johnmarkobura/analog-temperature-controller/ltspice/hysteresis_temperature_controller.asc

Heater: res; 44
LED: LED; LEDMODEL
R1: res; 481
R2_a: res; 5.1k
R2_b: res; 5.1k
Ra: res; 100
Rb: res; 1082
Rbottom: res; {1000*(1-a)}
Rc: res; 100
Rd: res; 1082
Re: res; 300
Rf: res; 39k
Rg: res; 1.2k
Rs: res; 5.6k
RT: res; R={-8.53503*TEMP(time)+1206.56688}
Rtop: res; {1000*a}
Schmitt: UniversalOpAmp2
SUB: UniversalOpAmp2
Temperature: bv; V=TEMP(time)
Transistor: npn3
V20: voltage; 20
V_ref: voltage; 5
VCC: voltage; 5
VEE: voltage; 5
VF1: UniversalOpAmp2
VF2: UniversalOpAmp2
Named nets: V2, 0, VCC, VEE, Vref, Vin, Vip, V1, V_sub, +20V, v_schmitt, Temperature
.param a=0.5
.model LEDMODEL D(Is=1e-20 N=2 Rs=10)
.func TEMP(t) table(t, 0,80, 50,90, 100,80)
.tran 0 100
