johnmarkobura/analog-temperature-controller/(commit log)

2026-09-05 Enhance README with project overview and details
    Expanded project details, including key features, thermistor characterization, signal conditioning, Schmitt trigger behavior, LTspice simulation results, hardware results, and tools used.
2026-09-05 Enhance README with project details and results
    Updated project description and added details about hysteresis, physical prototype results, and simulation vs hardware comparison.
2026-09-05 Revise README for clarity and consistency
    Updated terminology for clarity and consistency throughout the document, including changes to project goals, circuit descriptions, and measurement details.
